dilshan/tda1516-stereo-power-amplifier/design/tda1516bq-stereo-amp.pdf

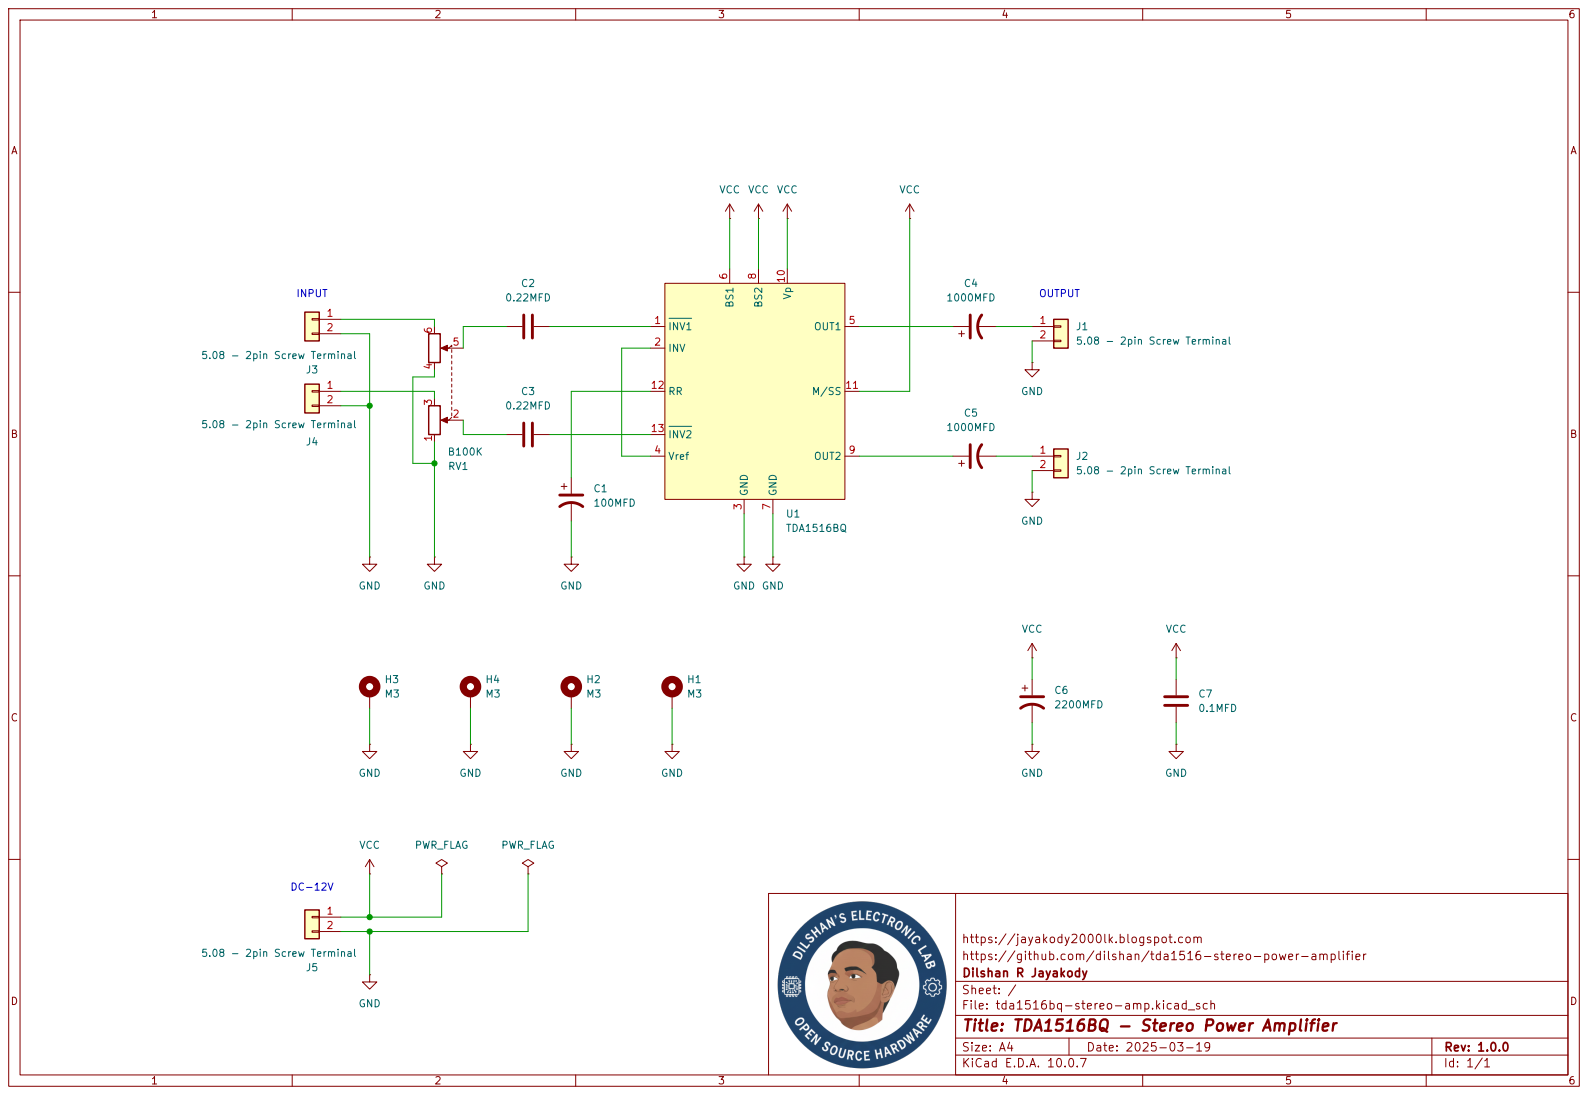
[picture p2: page 1]

https://jayakody2000lk.blogspot.com
https://github.com/dilshan/tda1516-stereo-power-amplifier
Dilshan R Jayakody
Sheet: /
File: tda1516bq-stereo-amp.kicad_sch
Title: TDA1516BQ - Stereo Power Amplifier

Size: A4 | Rev: 1.0.0
KiCad E.D.A. 10.0.7 | Id: 1/1
