dilshan/tda1516-stereo-power-amplifier/design/tda1516bq-stereo-amp.kicad_pcb

## KiCad design design/tda1516bq-stereo-amp.kicad_pcb (2026-10-31)

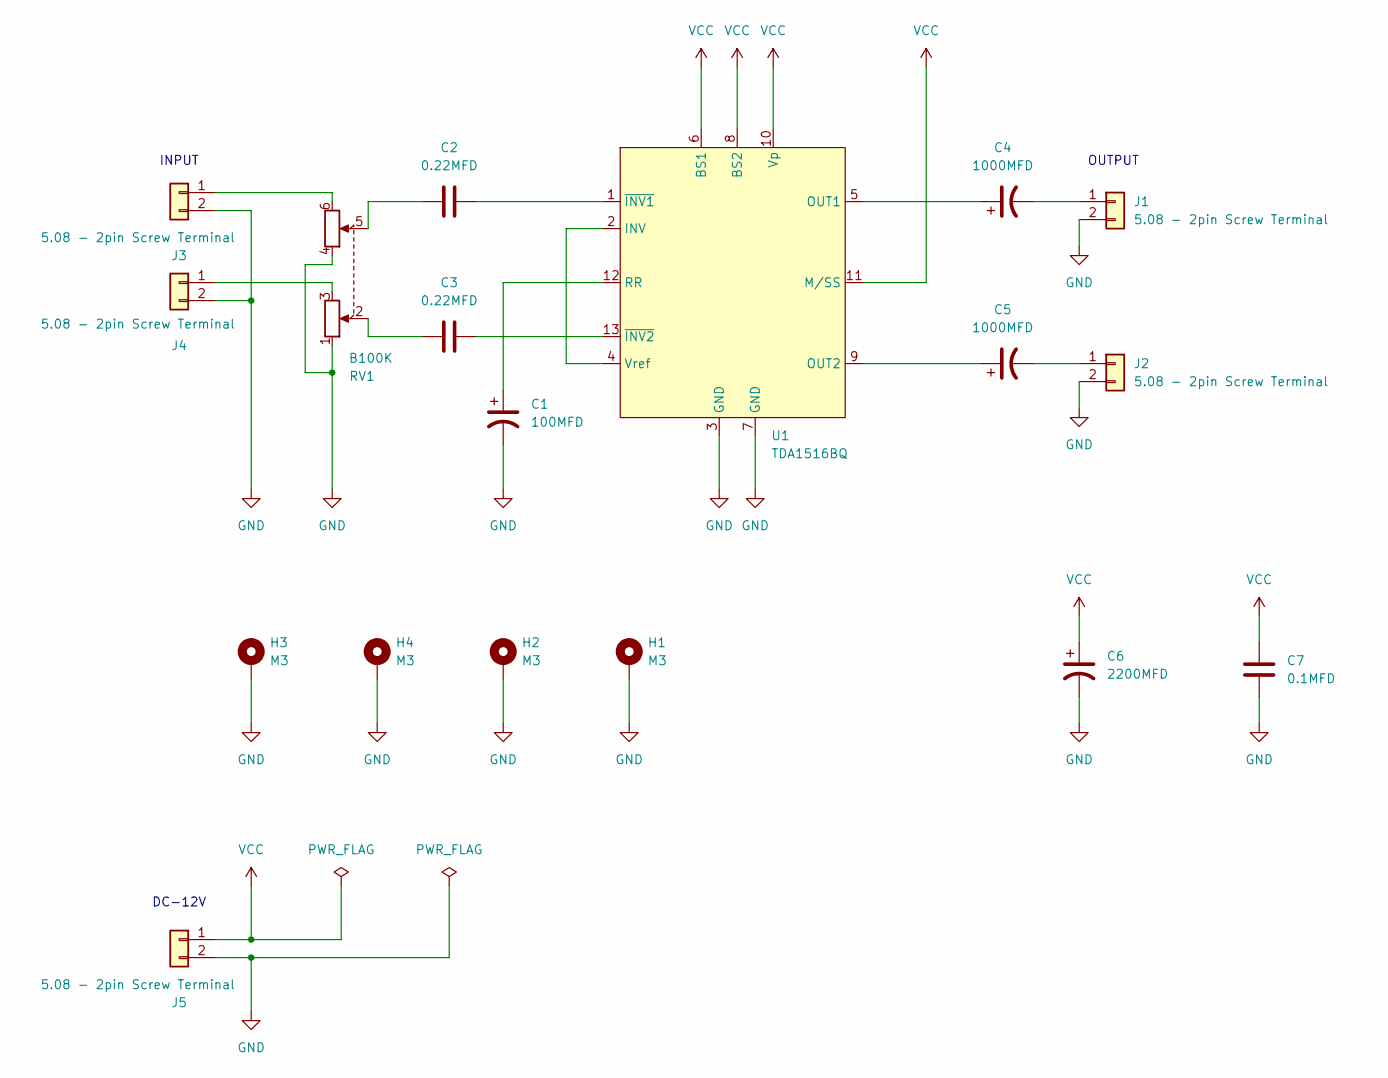
[picture p3: schematic tda1516bq-stereo-amp.kicad_sch, TDA1516BQ - Stereo Power Amplifier]

Parts:
C1: 100MFD; CP_Radial_D8.0mm_P3.80mm
C2, C3: 0.22MFD; C_Rect_L11.0mm_W5.1mm_P10.00mm_MKT
C4, C5: 1000MFD; CP_Radial_D12.5mm_P5.00mm
C6: 2200MFD; CP_Radial_D16.0mm_P7.50mm
C7: 0.1MFD; C_Rect_L9.0mm_W4.2mm_P7.50mm_MKT
H1, H2, H3, H4: M3; MountingHole_3.2mm_M3_DIN965_Pad
J1, J2, J3, J4, J5: 5.08 - 2pin Screw Terminal; PhoenixContact_MCV_1,5_2-G-5.08_1x02_P5.08mm_Vertical
RV1: B100K; Potentiometer_Dual
U1: TDA1516BQ; MULTIWAT-SIL13

Connections:
GND: C1.2, C6.2, C7.1, H1.1, H2.1, H3.1, H4.1, J1.2, J2.2, J3.2, J4.2, J5.2, RV1.1, RV1.4, U1.3 (GND), U1.7 (GND)
unnamed: C2.1, RV1.5
unnamed: C3.1, RV1.2
unnamed: C4.2, J1.1
unnamed: C5.2, J2.1
unnamed: J3.1, RV1.6
unnamed: J4.1, RV1.3
unnamed: U1.2 (INV), U1.4 (Vref)
unnamed: C4.1, U1.5 (OUT1)
unnamed: C5.1, U1.9 (OUT2)
unnamed: C1.1, U1.12 (RR)
unnamed: C2.2, U1.1 (~INV1)
unnamed: C3.2, U1.13 (~INV2)
VCC: C6.1, C7.2, J5.1, U1.6 (BS1), U1.8 (BS2), U1.10 (Vp), U1.11 (M/SS)

Notes on the sheet:
INPUT
DC-12V
OUTPUT

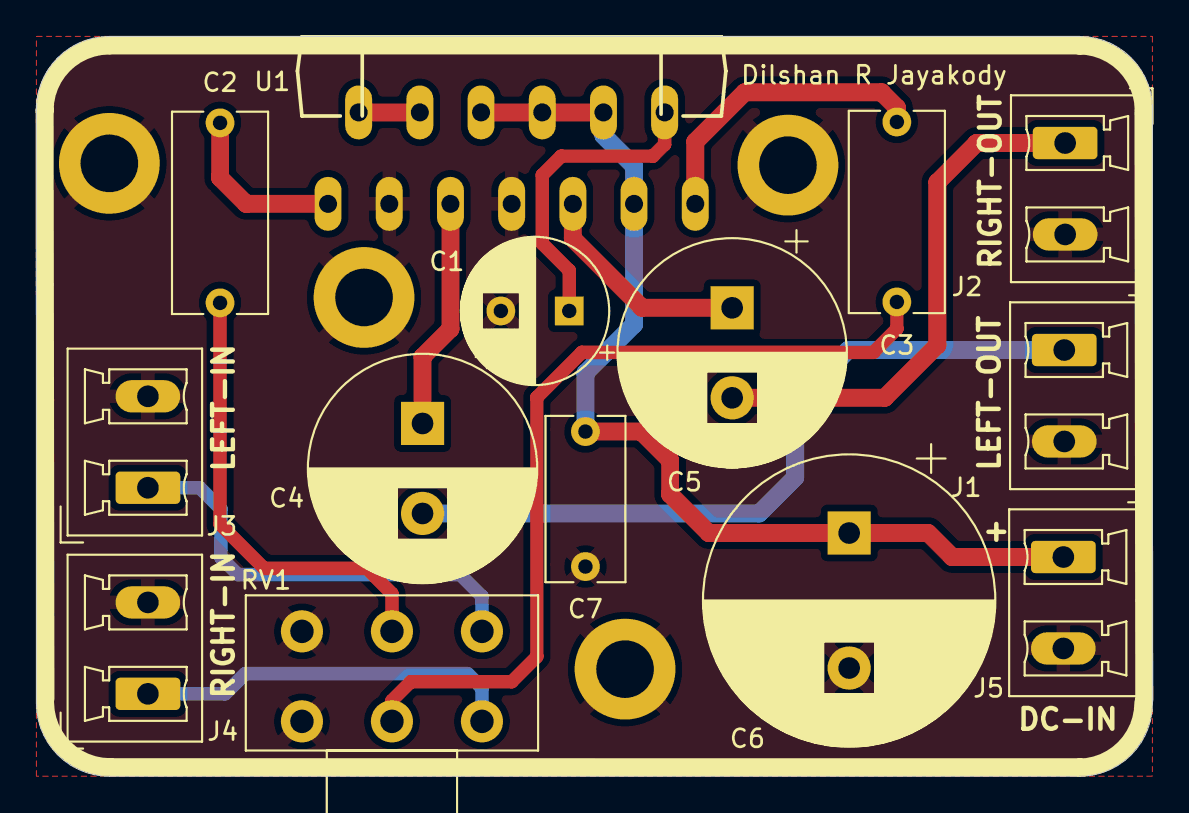
[picture p4: board tda1516bq-stereo-amp.kicad_pcb from above]

Board: 2 copper layers, 62.0 x 41.1 mm, 18 parts (0 on the bottom side), 14 nets.
