dilshan/tda1516-stereo-power-amplifier/(commit log)

2025-03-18 Add initial version of design files.
    [tda1516bq-stereo-amp.kicad_pcb, tda1516bq-stereo-amp.kicad_sch]
2026-10-31 Update schematic, PCB design files and KiCAD project to new version. Add CSV version of BoM file.
    [tda1516bq-stereo-amp.kicad_pcb, tda1516bq-stereo-amp.kicad_sch]
2026-10-31 Add CSV version of BoM file.
2026-10-31 Add image of the prototype build into the readme file.
2026-10-31 Add project gerber files.
    [tda1516bq-stereo-amp-B_Cu.gbl, tda1516bq-stereo-amp-B_Mask.gbs, tda1516bq-stereo-amp-B_Paste.gbp, tda1516bq-stereo-amp-B_Silkscreen.gbo, tda1516bq-stereo-amp-Edge_Cuts.gm1, tda1516bq-stereo-amp-F_Cu.gtl, tda1516bq-stereo-amp-F_Mask.gts, tda1516bq-stereo-amp-F_Paste.gtp]
2026-10-31 Add image of prototype build into readme file.
2026-10-31 Add schematic in PDF format.
2026-10-31 Add link to PCBWay project page.
